0xdxn/hull20/cut-files/previews/belly-bezel.png

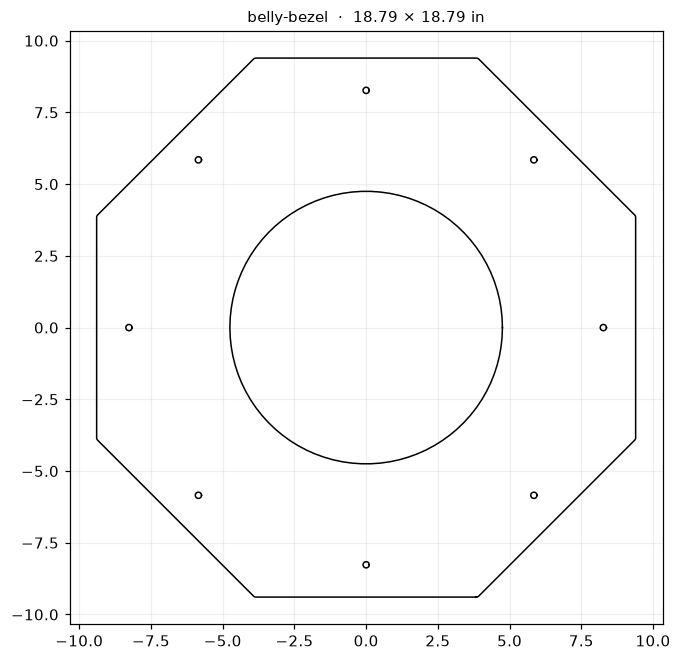
cut-files/previews/belly-bezel.png
