0xdxn/hull20/cut-files/previews/belly-panel-leg.png

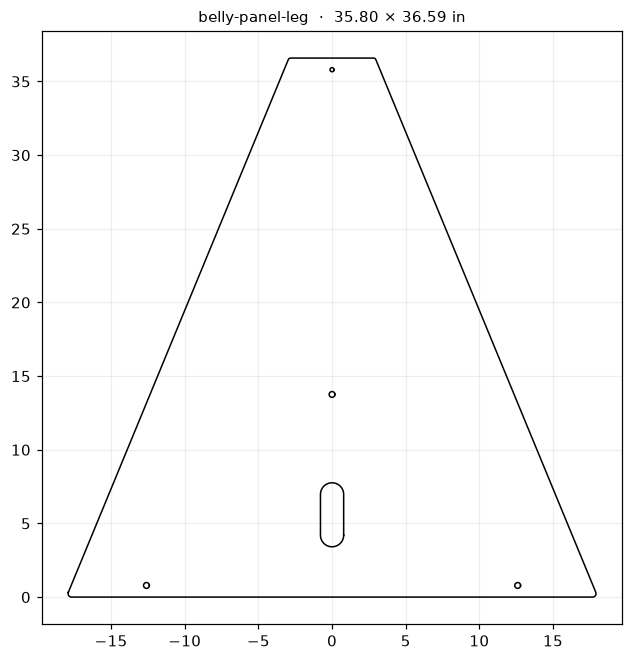
cut-files/previews/belly-panel-leg.png
