0xdxn/hull20/cut-files/previews/centre-plate.png

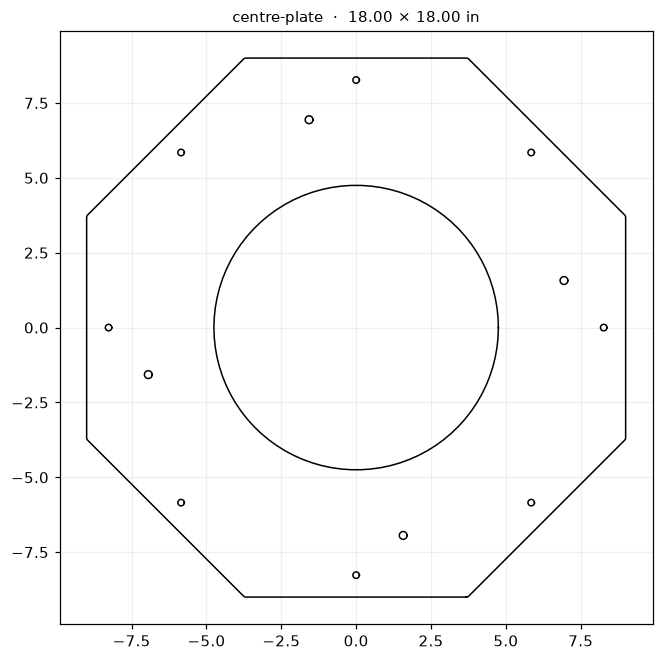
cut-files/previews/centre-plate.png
