0xdxn/hull20/cut-files/previews/deck-plate.png

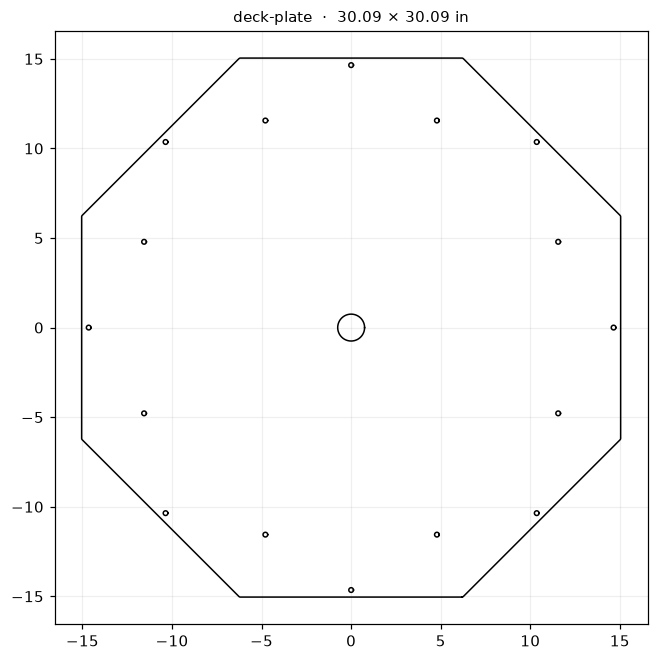
cut-files/previews/deck-plate.png
