0xdxn/hull20/cut-files/previews/porthole-plate.png

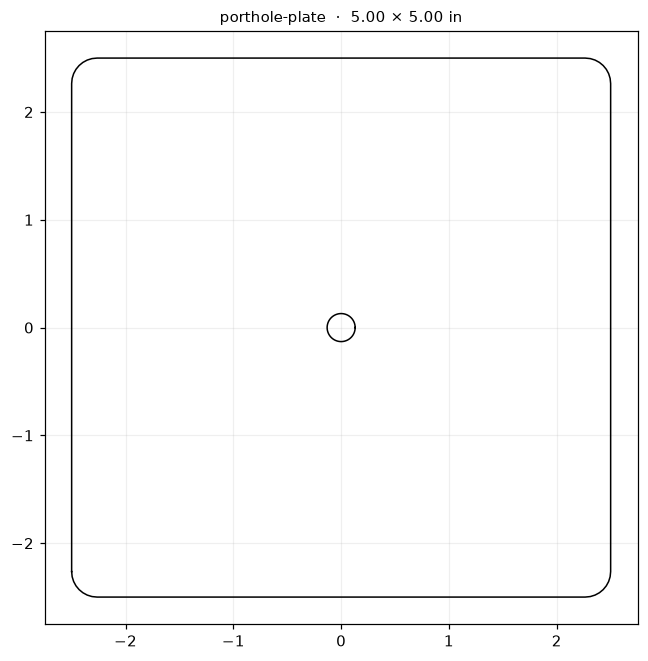
cut-files/previews/porthole-plate.png
