0xdxn/hull20/cut-files/previews/top-panel-lift.png

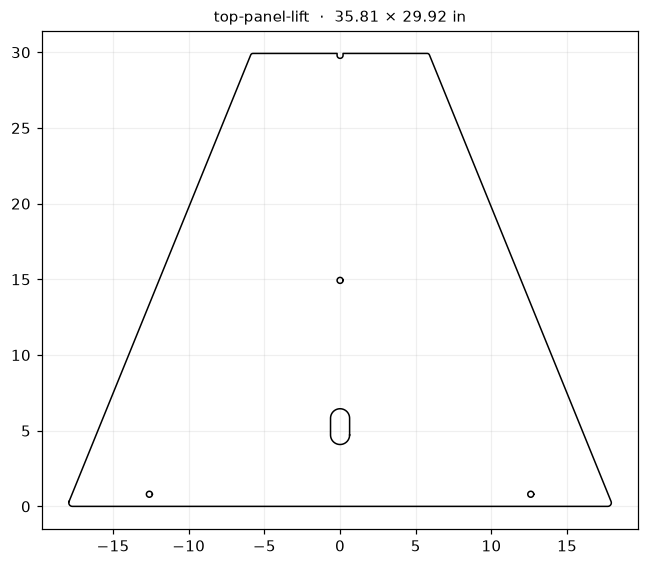
cut-files/previews/top-panel-lift.png
