0xdxn/hull20/sim/assets/plan-belly-uv.jpg

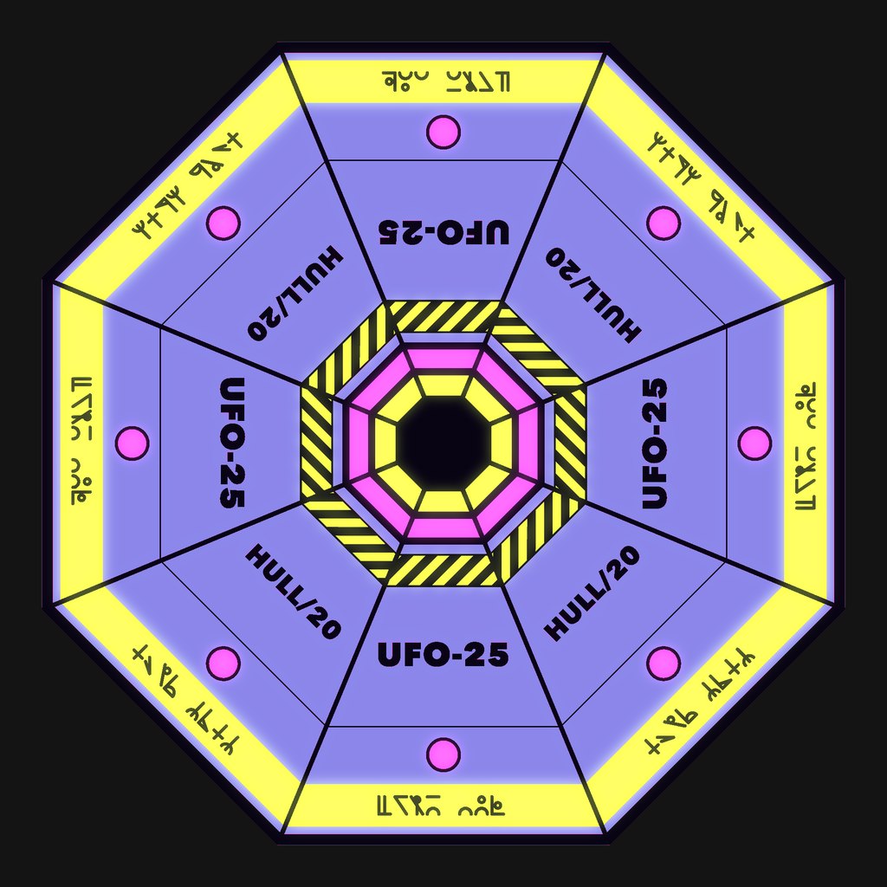
sim/assets/plan-belly-uv.jpg
