0xdxn/hull20/sim/assets/plan-belly.jpg

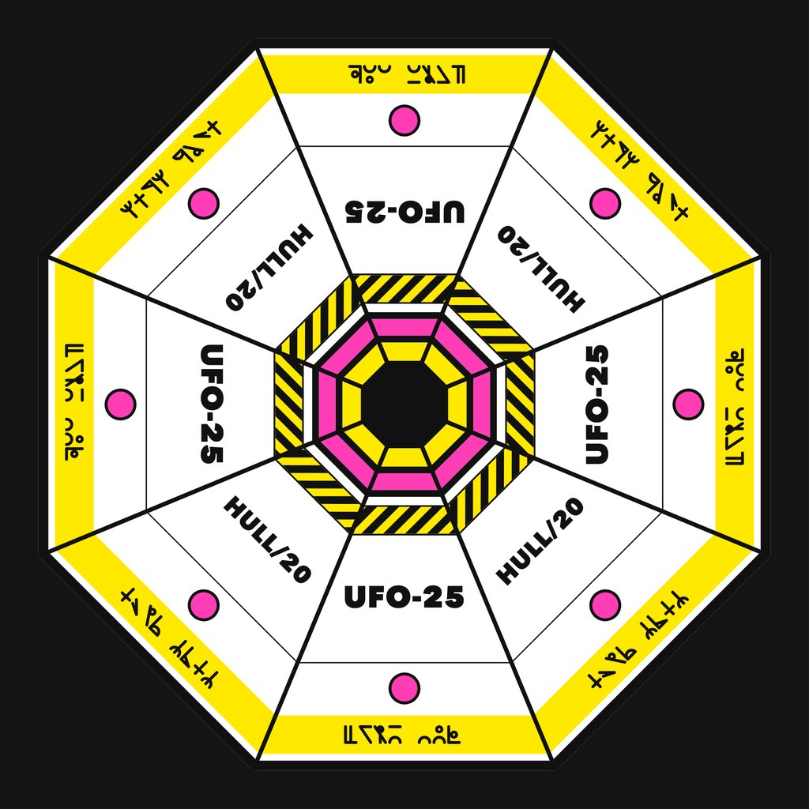
sim/assets/plan-belly.jpg
