0xdxn/hull20/sim/assets/plan-top-uv.jpg

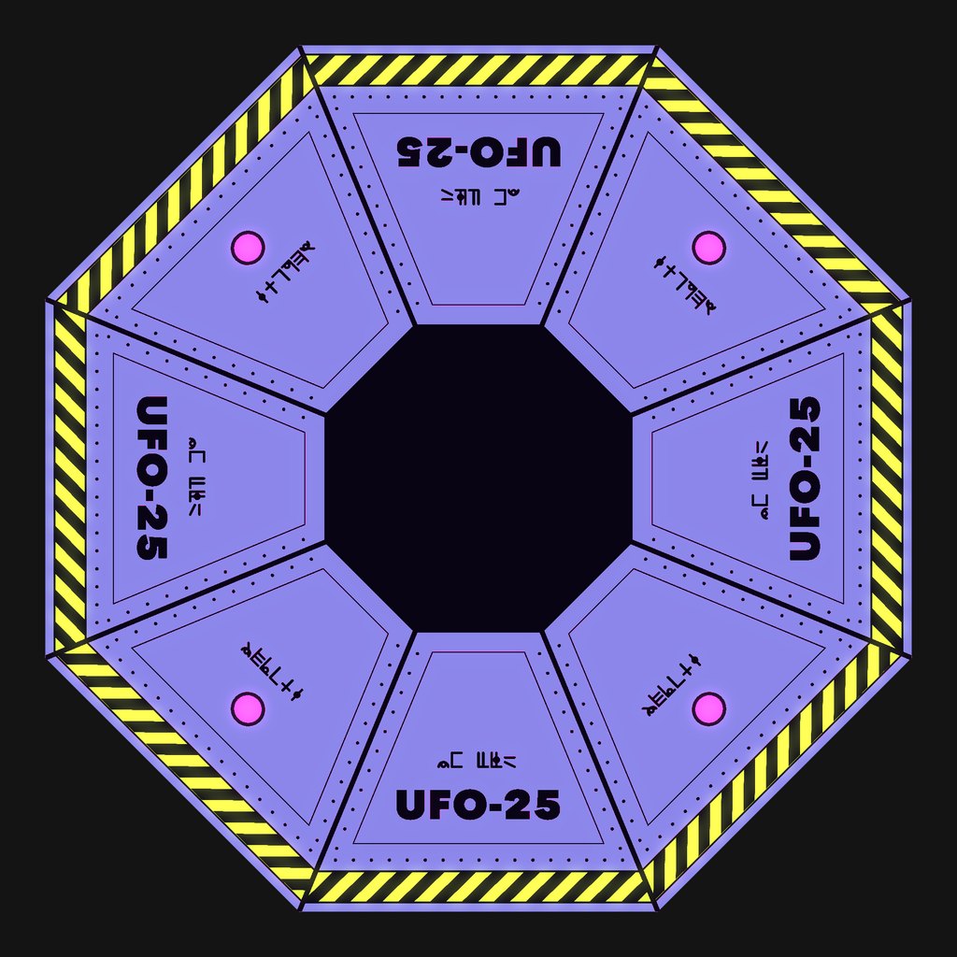
sim/assets/plan-top-uv.jpg
