0xdxn/hull20/sim/assets/plan-top.jpg

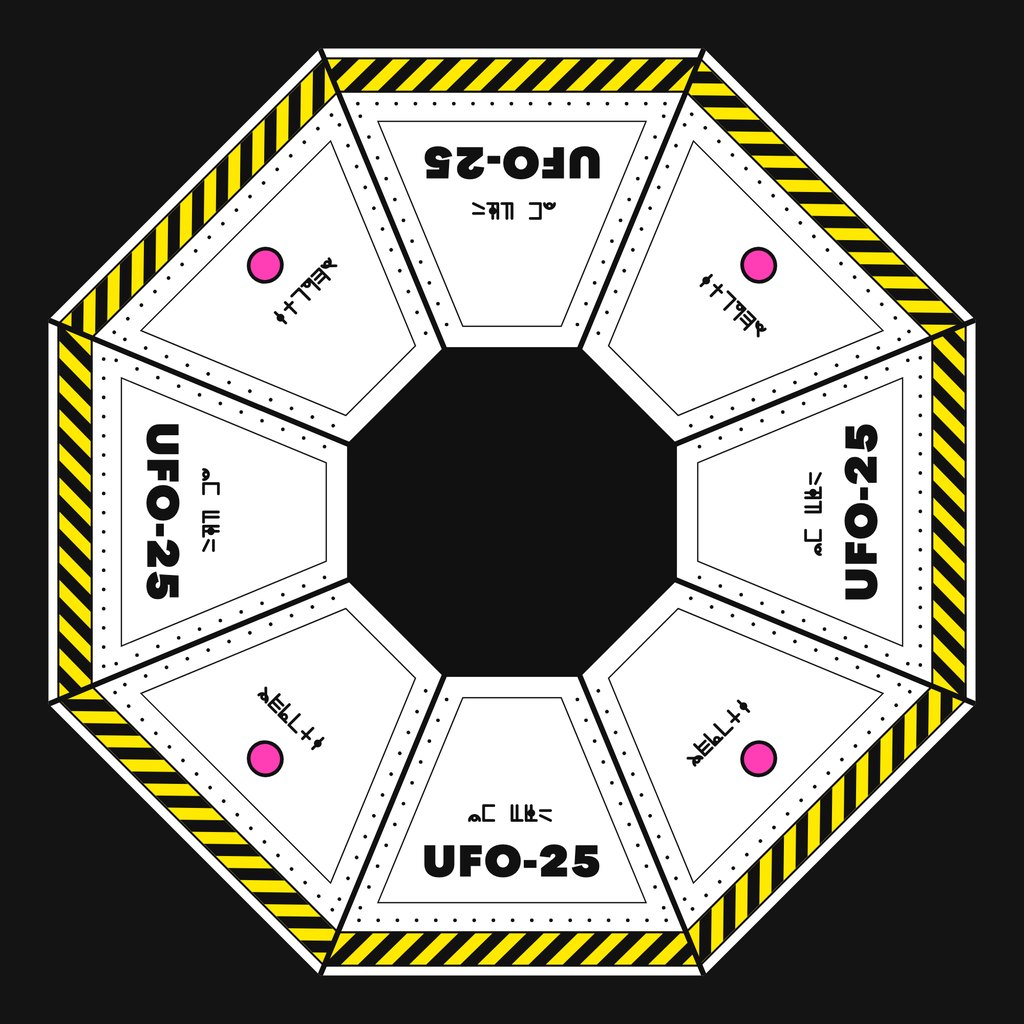
sim/assets/plan-top.jpg
