0xdxn/hull20/pcb/boarding-pass/fab/boarding-pass-bom.csv

Comment | Designator | Footprint | LCSC Part #
LTST-C230KSKT | D1,D2,D3,D4,D5,D6 | LED_LTST-C230 | C125108
USB-C | J1 | USB_C_HRO_TYPE-C-31-M-12_Flush | C165948
MMBT3904 | Q1,Q2 | SOT-23 | C20526
5.1k | R1,R2 | R_0603_1608Metric | C23186
100k | R3 | R_0603_1608Metric | C25803
10M | R4 | R_0603_1608Metric | C7250
4.7M | R5 | R_0603_1608Metric | C177475
220 | R6,R7,R8,R10 | R_0603_1608Metric | C22962
4.7k | R9 | R_0603_1608Metric | C23162
