0xdxn/hull20/cut-files/top-panel-lift.dxf

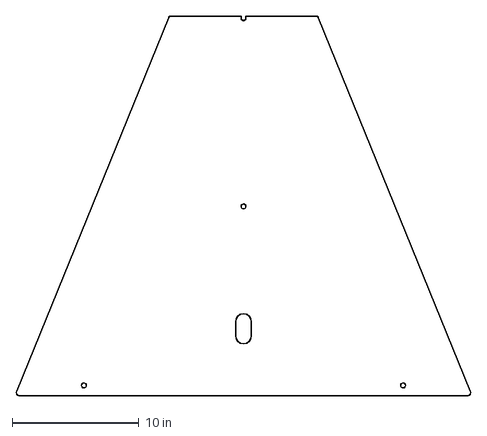
[picture p13: CAD file, 2026-11-01]
cut-files/top-panel-lift.dxf
35.9 x 29.9 in
