0xdxn/hull20/cut-files/deck-plate.dxf

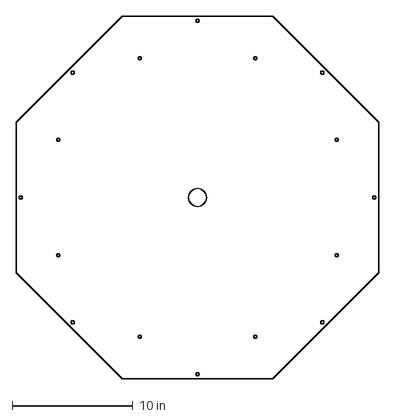
[picture p14: CAD file, 2026-11-01]
cut-files/deck-plate.dxf
30.1 x 30.1 in
