0xdxn/hull20/cut-files/belly-panel.dxf

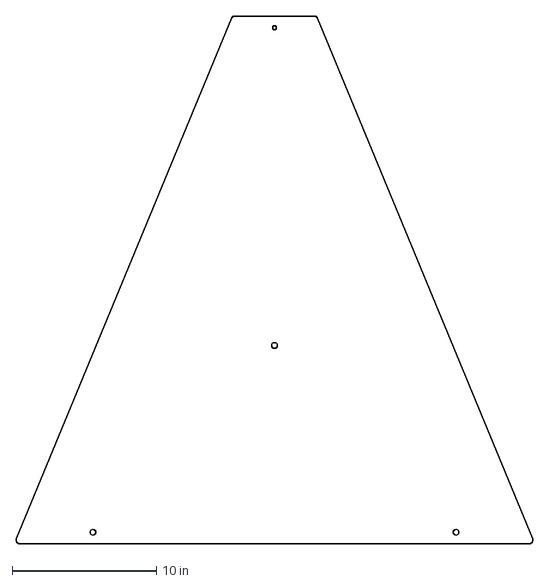
[picture p15: CAD file, 2026-11-01]
cut-files/belly-panel.dxf
35.9 x 36.6 in
