0xdxn/hull20/cut-files/belly-panel-leg.dxf

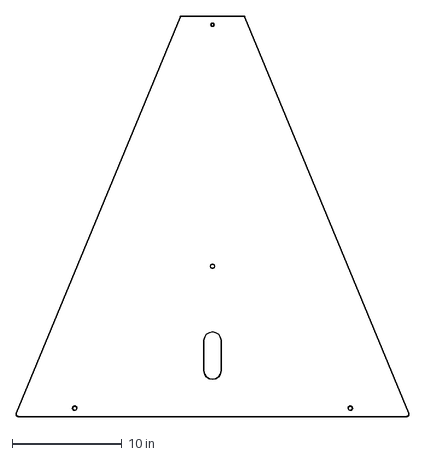
[picture p16: CAD file, 2026-11-01]
cut-files/belly-panel-leg.dxf
35.9 x 36.6 in
