0xdxn/hull20/cut-files/belly-bezel.dxf

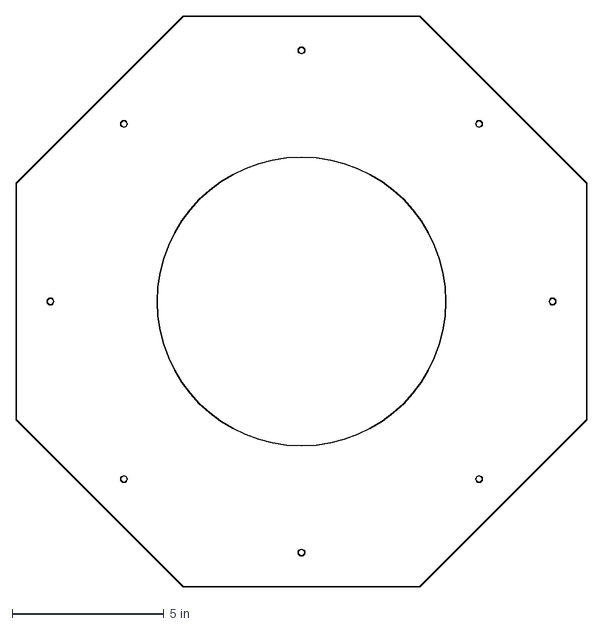
[picture p17: CAD file, 2026-11-01]
cut-files/belly-bezel.dxf
18.8 x 18.8 in
