0xdxn/hull20/cut-files/top-panel.dxf

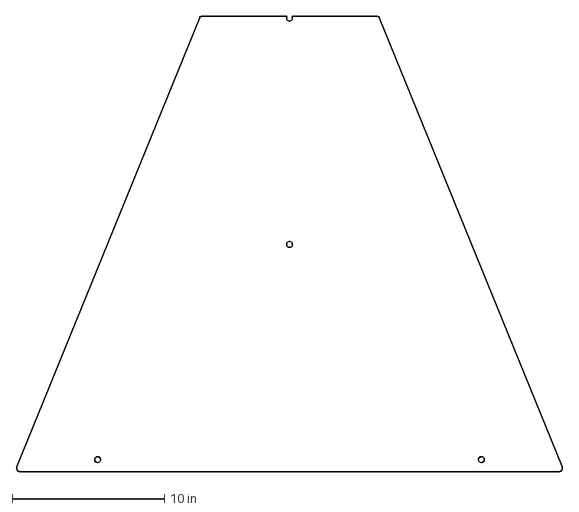
[picture p18: CAD file, 2026-11-01]
cut-files/top-panel.dxf
35.9 x 29.9 in
