0xdxn/hull20/cut-files/centre-plate.dxf

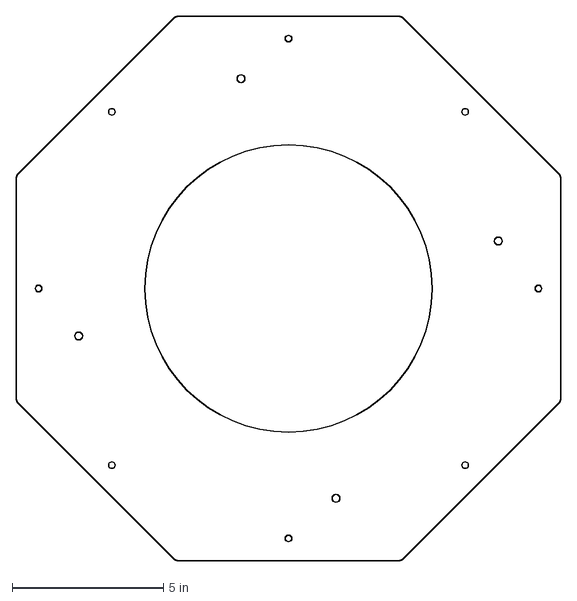
[picture p19: CAD file, 2026-11-01]
cut-files/centre-plate.dxf
18.0 x 18.0 in
