0xdxn/hull20/cut-files/porthole-plate.dxf

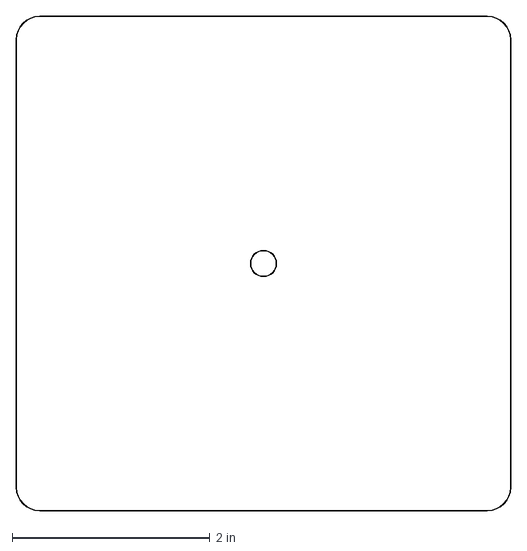
[picture p20: CAD file, 2026-11-01]
cut-files/porthole-plate.dxf
5.00 x 5.00 in
