0xdxn/hull20/frame/ASSEMBLY.html

# UFO frame: putting it together

The build in order, from the frame plan (FRAME-2020.html, build order and joints J1 to J12). Drawings are from above, B1 pointing right, numbered counter-clockwise. Holes come from DRILL-TAP.

this stepalready built

Every M6: a drop of blue Loctite 243 (not on the temporary hub-ring screws). Snug everything in a step first, check it, then tighten. Hex keys: 4 mm (M6 socket and button heads), 3 mm (M5 flat-heads).

## What the D (core ring) holes are for

Hole | Which D | Joint | What goes through it
68.9 | all 8 | J3 | M6 × 40 from inside the ring into the spoke's IN end: it's what holds each spoke to the centre
29 | all 8 (drilled on all) | J8, J11 | D2, D4, D6, D8: M6 × 40 down into a plate leg (the legs carry the centre plate, beam pod, iris). D1 and D5: one box-rail bolt each (step 7). D3 and D7: spare, leave empty
≈ 45, both ends | all 8 | J7 | the 135° corner brackets that make the eight D pieces one ring
rail holes | D1, D5 | J11 | M6 × 50 + nylock through each box rail (the box sits on the two rails): one end of each rail uses the existing 29 hole, the other is drilled at assembly

## Steps

### 1 Rim octagon J1 × 8

The eight A rims on the floor, countersunk 450 holes facing out. Each corner: inner corners touching, 135° bracket on the inner faces, 2 × M5 × 35 flat-head from outside + nylock (Corners section of DRILL-TAP).

Check: flat on the floor, and across the flats (outside to outside) the same three ways: 2213 mm (87⅛ in).

Hardware: 16 × M5 × 35 flat-head, 16 × M5 nylock, 8 brackets

Core ring, closer

### 2 Core ring J7 × 8

The eight D pieces into the small octagon the same way. All eight have the 29 mm hole now, so any piece can go anywhere: number them D1 to D8 going round as you fit them. Turn each so its 29 hole is on top and its dot end points the same way round (clockwise from above). That puts the extra holes on D1 and D5 exactly where the box rails need them (step 7).

Check: outside across the flats ≈ 373 mm (what the H rails were cut to), all four ways.

Hardware: 16 × M5 × 35 flat-head, 16 × M5 nylock, 8 brackets

### 3 Spokes J2 + J3, × 8

Each spoke runs from a rim mid-side to a core-ring mid-side, IN end at the core ring, B1 to D1, B2 to D2 and so on. All spoke holes (186, 558, 754) on top.

- Outer end (J2): M6 × 40 flat-head from outside the rim, through the countersunk 450 hole, into the spoke's tapped end. Sits flush; LED line A covers it.
- Inner end (J3): M6 × 40 socket-head from inside the core ring, through the 68.9 hole, into the spoke's IN end. The head sits between the two bracket legs.

Check: rim and spokes flush on top; the frame sits flat with no rock. Do opposite spokes first (B1 + B5, B3 + B7), then the rest.

Hardware: 8 × M6 × 40 flat-head, 8 × M6 × 40 socket-head

### 4 Hub posts J4 × 8

One E post (142) standing up on each spoke at the 186 hole. M6 × 40 up through the spoke from underneath into the post's tapped bottom end.

Check: posts vertical and the same way round.

Hardware: 8 × M6 × 40 socket-head

### 5 Hub ring J6 × 8, J5 temporary

Build the eight C pieces into an octagon (brackets as before), then set it on the posts: each C's centre 150 hole over a post.

For now: one M6 × 40 down through each 150 hole into the post's top (spares from the third pack). Later, when the deck plate goes on over the mesh, each one is swapped for the M6 × 50 that goes through the deck too (J5).

Hardware: 16 × M5 × 35 flat-head, 16 nylocks, 8 brackets; 8 × M6 × 40 (temporary)

### 6 Porthole posts J10 × 8

One K post (60) on each spoke at the 558 hole. M6 × 40 up through the spoke into the post. The porthole plates go on later (M6 × 25 down through the plate).

Hardware: 8 × M6 × 40 socket-head

Core ring, closer

### 7 Box rails J11 × 2

The two H rails (373) lie across the top of the core ring, from D5 to D1, 39.9 mm either side of the centre (79.8 mm apart), ends flush with the ring's outside faces. Not 50: at 50 every rail hole would land 10 mm from the extra 29 mm hole. At 39.9 the extra holes are rail holes.

- Each rail uses one hole that's already there: the 29 hole on D1 for one rail, the 29 hole on D5 for the other (they sit on opposite sides because the dot ends all point clockwise).
- Set the rail over the existing hole and drill 6.5 mm down through the rail, using the hole in the ring as the guide. At its other end, drill straight down through rail and ring together, 10 mm from the rail end (rail centred on the D bar). That end's hole is 29 mm from the D's other end: 2 new ring holes in all.
- Before drilling, check the bit clears the corner-bracket bolts inside the ring; slide the rail a few mm if not.
- M6 × 50 down through rail and ring, nylock underneath.

Hardware: 4 × M6 × 50 button-head, 4 × M6 nylock

Core ring, closer

### 8 Centre plate J8 × 4

Four F legs (90) hang under D2, D4, D6, D8: M6 × 40 down through each 29 mm hole into the leg's tapped top. Then the ½ in centre plate (18 in octagon, 9½ in beam port) under the legs: M6 × 25 up through the plate into each leg.

Hardware: 4 × M6 × 40 socket-head, 4 × M6 × 25 button-head + fender washers

### 9 Lift points J12 × 4

On B1, B3, B5, B7, centred 814 mm from IN (1000 mm from the centre): a 316 pad eye on top and one underneath, sharing two holes. Mark the holes from the pad eye, drill 6.5 mm, 2 × M6 × 40 straight through + nylocks. Rigging Fig 3 has the bridle.

Hardware: 8 pad eyes, 8 × M6 × 40, 8 × M6 nylock

## After the frame

From the frame plan's build order: LED channels (line A on the rim, belly battens rim to plate), snag-proofing (file and tape the 16 outside corners, cap the 48 bolt tails, scrap-of-mesh test), belly sail into the rim's inner slot, aluminet into the rim's top slot, then the deck plate over the mesh on the hub ring (swap the 8 temporary screws for M6 × 50, J5), riser posts (J9, M6 × 25 up through the deck and down through the dome lip with fender washers), dome lip. Full show on the ground, then hang.
