0xdxn/hull20/docs/wiring/CONTROLLER-STACK.html

# UFO controller · wire it one connection at a time

Two boards, stacked. Board A (the big one, rows 1–30) holds the Nano ESP32 and one chip, U1. Board B (the small one) holds four resistors, and it's where the wires to the light strips and from the power box are soldered in. There are no screw terminals: every wire is soldered straight into a hole. Six short wires join the two boards.

Updated 2026-10-25 to match what's on the ship: no fog machine and no beams. Everything that stays is in the same holes as before, so anything you've already soldered is still right.

## Parts list

How many | Part | How to find it | Goes
4 | 330 Ω resistors (R1–R4) | Colour bands orange, orange, brown, gold (4-band), or orange, orange, black, black, brown (5-band). Not sure? A meter on Ω reads about 330. Either way round. | Board B, standing up, hole h
1 | C1, 0.1 µF ceramic capacitor | Small, usually yellow or tan, two legs, printed 104. Either way round. | Board A, next to the chip
1 | C3, electrolytic capacitor, 100 µF or bigger (10 V or more) | A can. 100 µF is fine here; 1000 µF was the first plan. The stripe marks the − leg (also the shorter leg): it goes to GND, row 3. | Board B
1 | U1, 74AHCT125 chip | 14 legs, printed 74AHCT125 (or 74HCT125). Notch toward row 1. Stays out of its socket until the bench test. | Board A, in its socket
1 | 14-pin chip socket | Holds U1, so the chip itself is never soldered. | Board A, rows 17–23
2 | 15-pin female headers | The Nano ESP32 plugs into these. | Board A, rows 1–15
1 | Nano ESP32 + its USB-C power-only lead | The lead's red and black wires solder into board B. | Board A (Nano), board B (lead)
— | Wire: 20 AWG for power | The two wires from the power box's F6 fuse (red +5 V, black GND). 20 AWG or thicker. | Board B, rows 1 and 3, hole a
— | Wire: 22 AWG for data and jumpers | The four strip cables (DATA + GND each), the six ~10 cm wires between the boards, and the short jumpers on board A. Insulated, so it can cross over copper. | Both boards

### Telling the two capacitors apart

Only have up to 100 µF? Use a 100 µF can for C3 (10 V or more, stripe to row 3). This board only feeds the Nano and the chip, which draw very little, so 100 µF is plenty. Don't use the tiny ones (10 µF, 47 µF). Still not sure? Send a photo of the ones you have and I'll name each one.

No screw terminals. Every wire, including the power-box wires and the strip cables, is soldered straight into its hole.

## What the marks in the drawings mean

Each coloured line in a drawing is one separate wire with exactly two ends. Nothing is spliced together. The two ends are the two holes circled in that wire's step: solder one end in each. A wire only connects where it ends in a hole.

Naming a hole: row 17, hole A means go down to row 17 (numbers down both sides), then across to hole A (letters along the top and bottom). Board B's holes are lower-case: row 1, hole a. On board A, holes A to E of one row sit on one copper bar and are already joined; so are F to J. One row is not joined to the next, and the left half is not joined to the right half.

The basics: power versus data, and how the copper joins holes

### 1 · What runs to each light strip?

Every strip has three wires: +5 V, GND and DATA. They come from two different places:

- Power (+5 V and GND) comes from the power box, through its fuses, straight to the strips. It does not go through this little controller board. Nothing is 12 V any more (the beams are gone).
- DATA comes from this controller board. Each run of lights gets one 2-wire cable soldered into board B: DATA + GND. The GND in that cable is a reference so the data signal is read cleanly; it isn't the strip's power.

Soldered into board B | Light run | Other end: the strip's input end at
DATA row 1, hole j · GND row 3, hole j | rim edge | the aft flat's left corner
DATA row 5, hole j · GND row 7, hole j | cockpit dome lip (RGBW) | the top junction under the dome
DATA row 9, hole j · GND row 11, hole j | belly spokes, then the iris | spoke S1, at the centre
DATA row 13, hole j · GND row 15, hole j | portholes, then the alien's eyes | the top junction, to porthole P1

So: four cables leave the controller, one per run, each with a DATA wire and a GND wire. The strip's input end is the one the arrows point away from.

### 2 · How the copper on the boards works

These are prototype boards with copper bars printed underneath. On board A, the five holes A B C D E of a row sit on one bar and are joined to each other, and so are F G H I J. The two halves are not joined across the middle, and one row is not joined to the next. The long + and − bars down each side join every hole along them. Board B works the same way, just smaller.

The rule: you only add a wire when two things are on different bars. If two things already sit on the same bar, the copper has joined them; don't add a wire. Every step tells you exactly which two holes to join.

## Build it

◀ Back Next ▶ One stepWhole board

done Done, next ▶

Left and right arrow keys move between steps. The page remembers your ticks and where you were.

Everything at once, for checking at the end. It's busy on purpose; build from One step, one wire at a time.

## Bench test before it goes in the box

1. Chip out, Nano out. Meter board A: no beep between the + rail and the − rail.
2. Meter board B: no beep between row 1 and row 3 on the left half (+5 V and GND).
3. Push U1 into its socket, notch toward row 1. Push the Nano into its headers, USB-C at the row 1 end.
4. 5 V on the power-in wires (row 1, hole a and row 3, hole a) from the power box (through F6) or a bench supply. Nano powered by its USB-C lead.
5. Flash the test firmware (firmware/ufo-test: all four lines at once, each in its wire's colour: rim green, cockpit blue, spokes purple, portholes cyan). Connect a short test strip to one strip cable at a time (its DATA and GND wires, with the test strip's own 5 V from the same supply) and check it shows that line's colour. Passed 2026-10-25.
