0xdxn/hull20/docs/wiring/STRIP-PLAN.html

# UFO 2026 · strip plan

5 strips · 888 RGB + 115 RGBW used · 312 RGB + 185 RGBW spare · 10 cuts · nothing to buy · 2026-10-14

What you have and where every LED goes. The underside rim (line B) is dropped. The top rim is one continuous run, and the belly spokes are cut and joined with wire. Your four RGB strips and the RGBW strip were all bench-tested good on 2026-10-14. The wiring page (WIRING.html) carries the same data lines.

## 1 · Five strips, cut by cut

Each bar is one 5 m reel at 60 LEDs/m, input end on the left (the arrow on the strip points away from it). ✂ numbers match the checklist in section 5. Grey hatching is spare: leave it on the reel, uncut.

## 2 · Top rim: one continuous run (data line 1)

Seen from above. The strip runs clockwise from the aft flat's left corner (as on the wiring page), 55 LEDs per face, and passes uncut through each corner gap between the 36" channels. Strip 1 plugs into strip 2 with their factory connectors on face 6. Power taps at four corners, as before.

## 3 · Belly: eight spokes, snaked with wire (data line 3)

X-ray from above, same orientation as the top view. The data snakes through the spokes: S1 runs centre → edge, a wire runs along the edge to S2, S2 comes back in, a short wire crosses the hub to S3, and so on. S8 ends at the centre and feeds the iris. The firmware already maps this zig-zag.

## 4 · Four data lines

Line | Pin | Runs | LEDs | Strip
1 | Nano D2 · GPIO5 | top rim, clockwise from the aft-left corner | 440 | RGB 1 (300) → RGB 2 (140)
2 | Nano D3 · GPIO6 | cockpit: the 24" dome lip, from the top junction | 115 RGBW | RGBW, 4 bytes per LED, so it gets a line of its own
3 | Nano D4 · GPIO7 | spokes S1 → S8 snaked, then the iris disc | 448 + 241 = 689 | RGB 3 (S1–S5) RGB 4 (S6–S8) · iris: a 241 disc borrowed back from the round eyes
4 | Nano D5 · GPIO8 | top junction → portholes P1…P8 → the alien's 2 eye pixels | 128 + 2 = 130 | 8 of your 10 porthole rings (2 spare)

The longest line (3, 689 LEDs) still sets the frame time, about 48 frames a second. Line 2 carries far fewer LEDs than line B did. At its warmest, though, an RGBW pixel can draw a little more than an RGB one; the 30 A limiter covers it.

## 5 · Cuts and seals

1. Mark before you cut. Count LEDs from the input end and cut on the copper pads between two LEDs, through the middle of the pads.
2. The 10 cuts: ✂1 RGB 2 at 140 (end of the rim) · ✂2–✂6 RGB 3 at 56, 112, 168, 224, 280 (S1–S5) · ✂7–✂9 RGB 4 at 56, 112, 168 (S6–S8) · ✂10 RGBW at 115 (cockpit; measure the lip first, see below).
3. 20 cut ends get sealed. Where a jumper goes on, solder first, then seal: silicone end cap filled with neutral-cure silicone, or glue-lined heat shrink over the sleeve. The spare pieces' cut ends get sealed too, so the spares stay IP67.
4. Jumpers (22 AWG 3-core, #16): 4 at the rim (S1→S2, S3→S4, S5→S6, S7→S8), about 33" each; 3 at the hub (S2→S3, S4→S5, S6→S7), about 5" each; S8 → iris about 7". Leave 2" slack at each end.
5. Your heat-shrink-sealed strip is best as RGB 4. Its three spokes sit in belly channels, under the saucer and out of the rain, and most of it stays on the reel as the spare.
6. Measure the dome lip before ✂10. 115 LEDs assumes 75.4" (π × 24") at 60/m. Wrap a tape where the strip will actually sit; LEDs = inches × 0.79 (60/m). If the strip turns out to be 30/m, it's half that and the cut moves.

Spares: RGB 2 keeps 160, RGB 4 keeps 132, RGB 3 keeps 20 (312 RGB) and the RGBW keeps 185. A failed spoke or rim face can be swapped on show night. Also spare: the dense 1 m strip in its channel (wand or antenna) and a loose dense 1 m strip. Count its LEDs: 144/m is the usual dense density.
