0xdxn/hull20/docs/wiring/WIRING.html

# UFO 2026 · wiring

Current as of 2026-10-14. Four data lines: 1 top rim, 2 cockpit dome lip (RGBW), 3 belly spokes then iris, 4 portholes then eyes. Which strip becomes which run, every cut and the spoke jumpers: STRIP-PLAN.html. Anything drawn in purple dashes was planned and not built (a 12 V beam pod and a fog relay).

5 V: 1,374 px on 4 data lines (1,259 RGB + 115 RGBW) · cap 42 % · limiter 30 A · beam pod and fog relay: planned, not built
Controller Arduino Nano ESP32 (ESP32-S3; 5 V in through its USB-C port) + 2 × 74AHCT125 · Mean Well LRS-350-5 (+ LRS-75-12 only with the pod) · 6 fuses (+ F7 with the pod)
Box inside the 2020 aluminium frame, on two rails over the core ring, under the deck. Frame: ../../frame/FRAME-2020.html

+5 VGND +12 Vdata / signal mains Lmains N earthplanned, not built (beam pod, fog relay)

Mains. The only 120 V wiring is the cord into the box and the three short runs to the two power supplies. Unplug before opening the box. Plug only into a GFCI outlet. If you'd rather not do the mains side, an electrician can do those connections in a few minutes; everything else is 5 V (and 12 V for the beam pod, if fitted).

## 1 · System overview

Fig 1. One cord feeds the box. 5 V runs every pixel and the controller through six fuses, and the controller sends four buffered data lines. Purple dashes: a 12 V beam pod (LRS-75-12, F7, MOSFET) and a fog relay that were planned and not built. Leave them out and nothing else changes.

## 2 · Controller board (perfboard inside the box)

Fig 2. The four data lines go through U1 (3.3 V in, 5 V out) and a 330 Ω series resistor each. If the beam pod is fitted, D6 drives the MOSFET module directly, with a 10 kΩ pull-down so the pod stays off while the ESP32 boots. The relay gets a 5 V signal from U2 and the same pull-down, so the fog machine can't fire at power-up. Pin numbers are the 74AHCT125 DIP-14 pins.

Built on two ELPZON boards as a stack: CONTROLLER-STACK.html (hole-by-hole layout). Board build. Nano ESP32 on female headers (so it lifts out to flash), U1 and U2 in DIP-14 sockets, two-way or three-way screw terminals for J1–J6 and the 5 V input. Keep R1–R4 right at U1's outputs. Every data run leaves the board with its own GND wire beside it.

Power and flashing: the Nano ESP32 has no 5 V input pin, and its VIN needs 6–21 V (datasheet 11.3), so it takes its 5 V through its own USB-C port: a short USB-C power lead (power only) from the 5 V bus via F6. Never put 5 V on VIN. To flash, unplug that lead and plug in the laptop cable instead; nothing can backfeed.

## 3 · Power box: wiring and layout (to scale)

Fig 3a. Inside the box. Both supplies' −V go to one GND bus (one tie for the 12 V side, if the pod is fitted) so the controller, the MOSFET and every strip share a reference. The earth (⏚) of both supplies goes to the cord's ground.

Fig 3b. Box layout at 50 px per inch (inside 11.2 × 7.7 in). LRS-350-5 lies flat; LRS-75-12 sits on 1 in standoffs above its left end. The bottom strip holds the fuse row and the controller board. Mains stays in the top-right corner, away from the 5 V side. All glands are on the face that points down once the box sits on its rails inside the saucer, so water can't sit on them.

## 4 · Saucer routing (both views drawn from above; the belly is an x-ray)

Fig 4a. Top. Line 1 (lineA) runs on the 1.5 in rim edge, clockwise from the aft flat's left corner (aft at the top), one continuous strip, 55 LEDs per face. Feeds from ring bus A at the start of faces 1, 3, 5 and 7. The top junction (TJ) under the dome riser gets F2 + J2 and F5 + J4 up through the deck. Line 2 starts at the TJ and runs once round the dome lip (115 RGBW). Line 4 chains P1 → P8 on the 22/3 cable, then the eyes. The TJ also puts power into P1 and P5.

Fig 4b. Belly. Line 3 only: no strip on the belly's outer edge. The spokes are one serpentine data line: S1 runs outward, S2 inward, and so on, with rim jumpers along faces 1, 3, 5, 7 and short centre jumpers. S8 ends at the centre and feeds the iris. Spoke power comes from a star at the centre (F3); the iris has its own feed (F4).

The sim counts pixels from the middle of the aft flat. The strip starts at the aft flat's left corner, so the firmware shifts lineA by half a face (27 px). Spoke order and the serpentine direction are also mapped in firmware; wire it as drawn and the show matches the sim.

## 5 · Channels, fuses and wire

### Data channels

Ch | Nano pin | U1 in → out | Series R | Runs to | Pixels | Frame | Worst current at 42 %
1 | D2 · GPIO5 | 2 → 3 | R1 330 Ω | lineA, rim edge, from the aft flat's left corner, clockwise | 440 | 13.2 ms | 11.1 A
2 | D3 · GPIO6 | 5 → 6 | R2 330 Ω | cockpit: TJ → once round the 24" dome lip, RGBW strip (4 bytes per LED, so its own line) | 115 RGBW | 4.6 ms | ~4 A
3 | D4 · GPIO7 | 9 → 8 | R3 330 Ω | spokes S1–S8 serpentine, then the iris (centre) | 448 + 241 = 689 | 20.7 ms | 11.3 + 6.1 A
4 | D5 · GPIO8 | 12 → 11 | R4 330 Ω | top junction → P1…P8 → eyes | 128 + 2 = 130 | 3.9 ms | 3.3 A
beam | D6 · GPIO9 | direct | R5 10 kΩ pull-down | MOSFET module PWM+ (12 V pod, if fitted) | — | — | pod ≤ 5 A at 12 V
fog | D7 · GPIO10 | U2 2 → 3 | R6 10 kΩ pull-down | relay IN; COM + NO across the fog remote's button | — | — | —

The ESP32-S3 has four RMT transmit channels, one per data line, all sending at once. The longest line (ch 3, 689 px) sets the frame time, about 48 fps. "Worst current" is every pixel of that line full white at the 42 % cap (60 mA per pixel). The firmware's 30 A limiter holds the total; a single line can still reach its figure on its own, so each fuse is sized above it. With 16 portholes instead of 8, ch 4 becomes 358 px (10.7 ms) and F5 stays 10 A.

### Fuses (ATC blade, in the inline holders)

Fuse | Feeds | Rating | Wire from the box
F1 | lineA via ring bus A | 15 A | 14 AWG pair to the aft-left corner, then the ring bus
F2 | cockpit lip (RGBW), powered at the top junction | 10 A (15 A is fine) | 14 AWG pair up through the deck beside F5 (G3)
F3 | spoke star at the centre (8 spokes) | 15 A | 14 AWG pair, short: the spoke star is in the box, right over the beam port
F4 | iris | 10 A | 14 AWG pair to the disc's 5 V/GND pads, both outer ring and centre
F5 | top junction: portholes, cockpit, eyes | 10 A | 14 AWG pair up through a gland in the deck to the TJ (the box is right under it)
F6 | controller board | 3 A (5 A if the kit has nothing smaller) | 18 AWG inside the box
F7 | beam pod (12 V), only if fitted | 7.5 A | 16 AWG pair to the pod

### Wire

Run | Wire | Approx. length
Fused feeds from the box (F1–F5) | 14 AWG red/black pair | 5 × 1.5 m
Ring bus A around the inside of the rim | 14 AWG red/black pair | 7.5 m
Injection taps, bus → strip (4 per rim line), spoke star leads, TJ → P1/P5 | 18 AWG pair | ≈ 8 m
Data runs (with GND): J1 to the aft-left corner; J2 and J4 up to the TJ; J3 to S1 | 22 AWG 3-core (DATA, GND, spare) | ≈ 6 m
Spoke jumpers: 4 along the rim (36 in), 3 at the centre | 22 AWG 3-core (5 V, GND, DATA) | ≈ 4.5 m
Porthole chain P1 → P8 → eyes | 22 AWG 3-core | ≈ 6 m
Fog trigger pair (not built) | 22 AWG (2 cores of the 3-core) | —
Beam pod (if fitted) | 16 AWG pair (the pod's own lead if long enough) | ≈ 1 m

So: about 20 m (65 ft) of 14 AWG pair with slack, 8 m of 18 AWG pair and ≈ 20 m (65 ft) of 22/3. That's more than the 50 ft of 22/3 on the parts list, so get 100 ft. Put a 1000 µF capacitor across 5 V/GND where each strip starts (lineA, cockpit lip, S1, iris, TJ) plus C3 on the board: 6 in all. Seal every outdoor joint with adhesive-lined heat shrink.

## 6 · Connection checklist (tick as you go)

## 7 · Bring-up order

1. Bench, USB only. Controller board on USB, no supplies. Flash the test firmware. One short test strip on J1, then J2, J3, J4: each shows a single-pixel chase.
2. Supplies, no loads. Wire the mains side, close the lid, plug into the GFCI. Meter: LRS-350-5 at 5.0 V, trim to 5.1 V. LRS-75-12 at 12 V (if fitted). Unplug.
3. One fuse at a time, test firmware capped at 10 %: F6 (board), then F1 (lineA), F2, F3, F4, F5. On each, check the pixel count, the direction and the start corner against fig 4.
4. Voltage at the far end. Each line full white at the 42 % cap: at least 4.6 V at the last pixel. If it's lower, add a tap from the ring bus there.
5. Beam (if fitted). PWM ramp 0 → 100 %: the pod fades smoothly. Pull F6 and check that the pod stays dark (the pull-down works).
6. Full show on the ground first: clamp meter on the LRS-350-5 output during an abduction, ≤ 30 A.
7. Last. Glands tight, GFCI test button pressed, box level.

## 8 · Open items

1. Fog relay. Planned and not built.

2. Portholes 8 vs 16. Drawn for 8. 16 adds a second ring per top facet; ch 4 goes to 358 px, the chain doubles, nothing else changes.

3. Dome lip. Measure where the cockpit strip will actually sit before cutting the RGBW (✂10 on the strip plan): LEDs = inches × 0.79 at 60/m. 115 assumes 75.4".

4. Beam pod. Not built. Without it, leave out the LRS-75-12, F7, the MOSFET and gland G6; D6 stays unused.
