0xdxn/hull20/pcb/boarding-pass/fab/boarding-pass-schematic.pdf

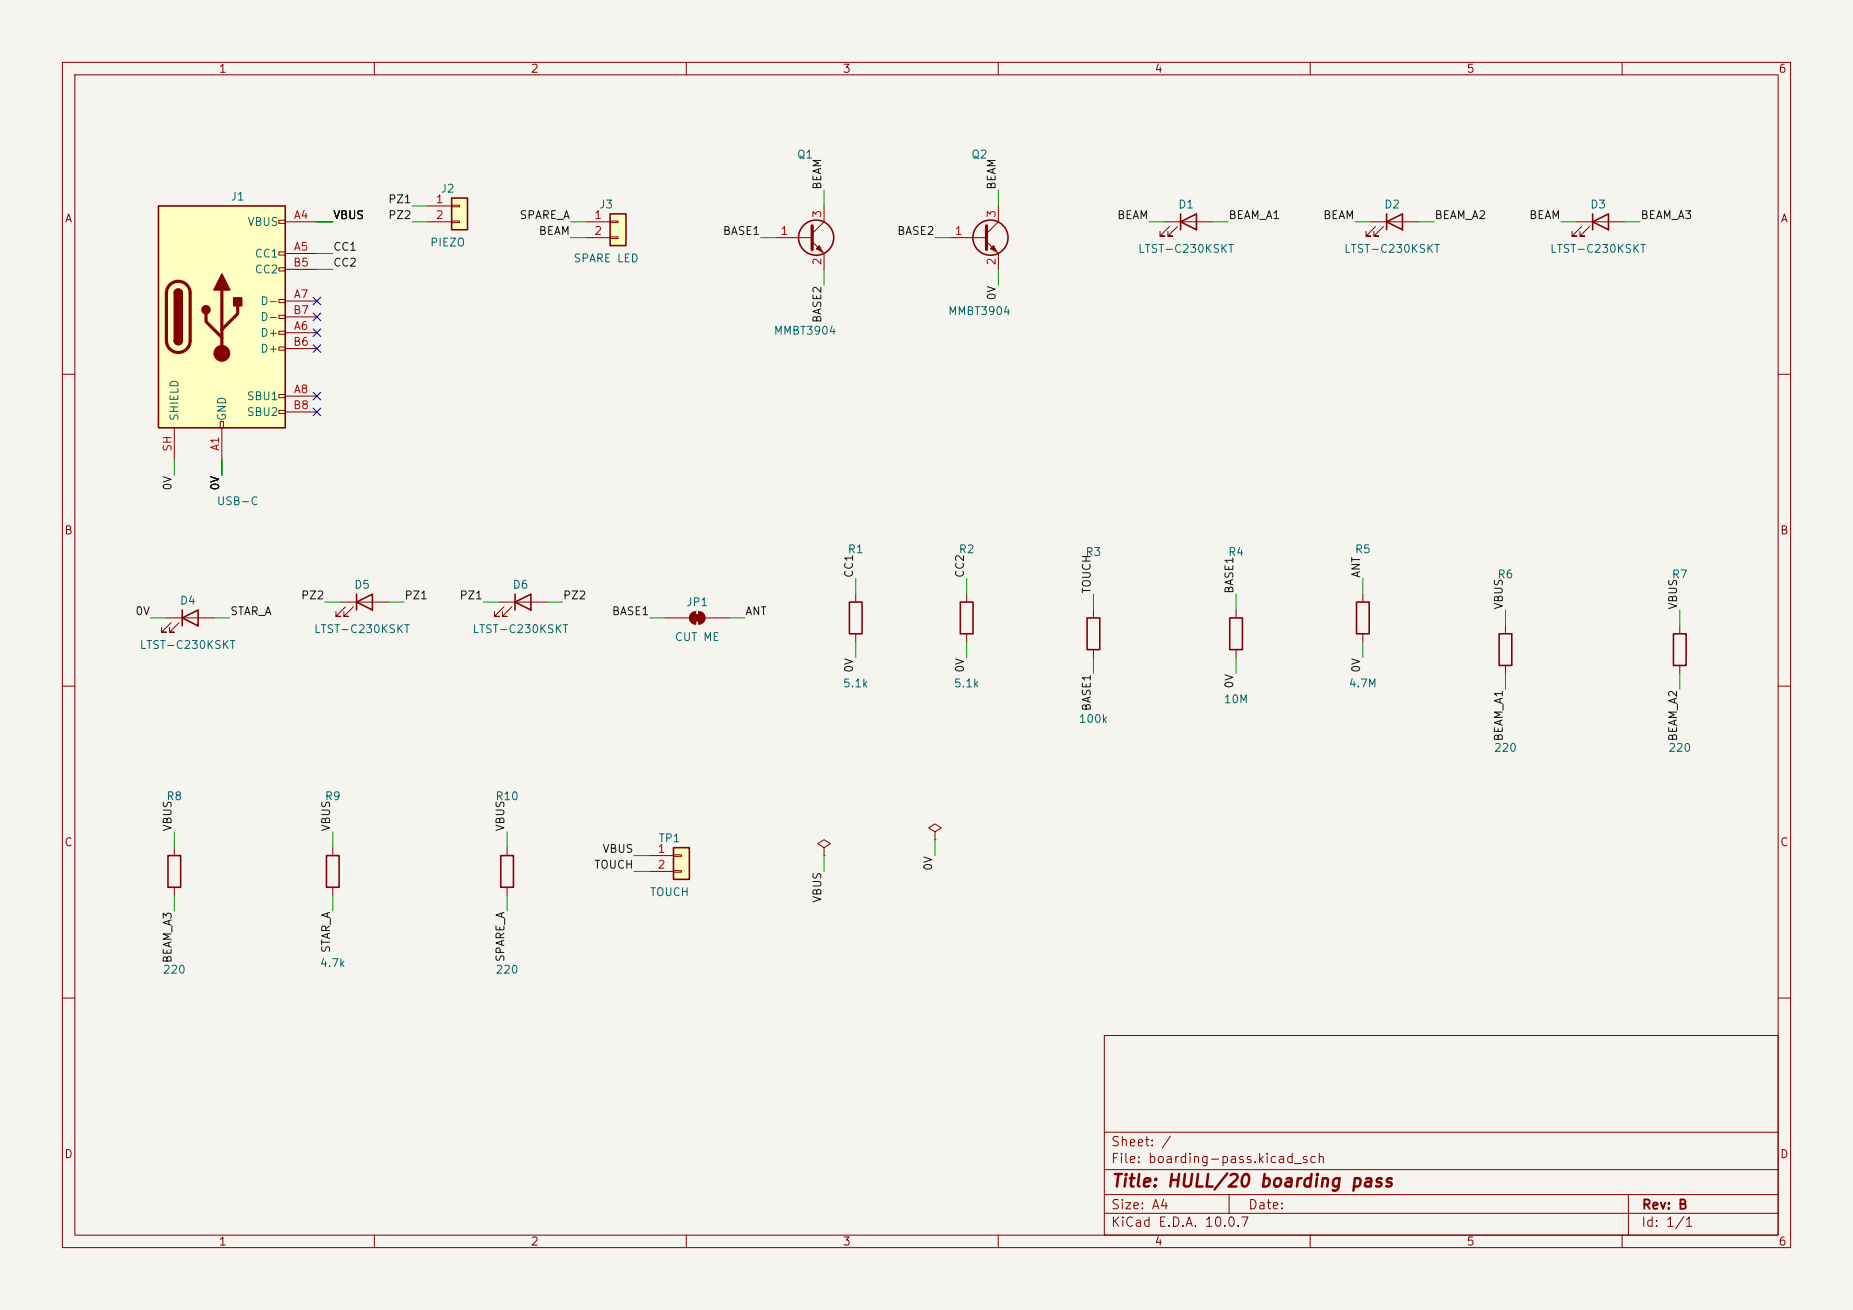
[picture p21: page 1]

Sheet: /
File: boarding-pass.kicad_sch
Title: HULL/20 boarding pass

Size: A4 | Rev: B
KiCad E.D.A. 10.0.7 | Id: 1/1
