0xdxn/hull20/pcb/boarding-pass/boarding-pass.kicad_pcb

## KiCad design pcb/boarding-pass/boarding-pass.kicad_pcb (2026-11-01)

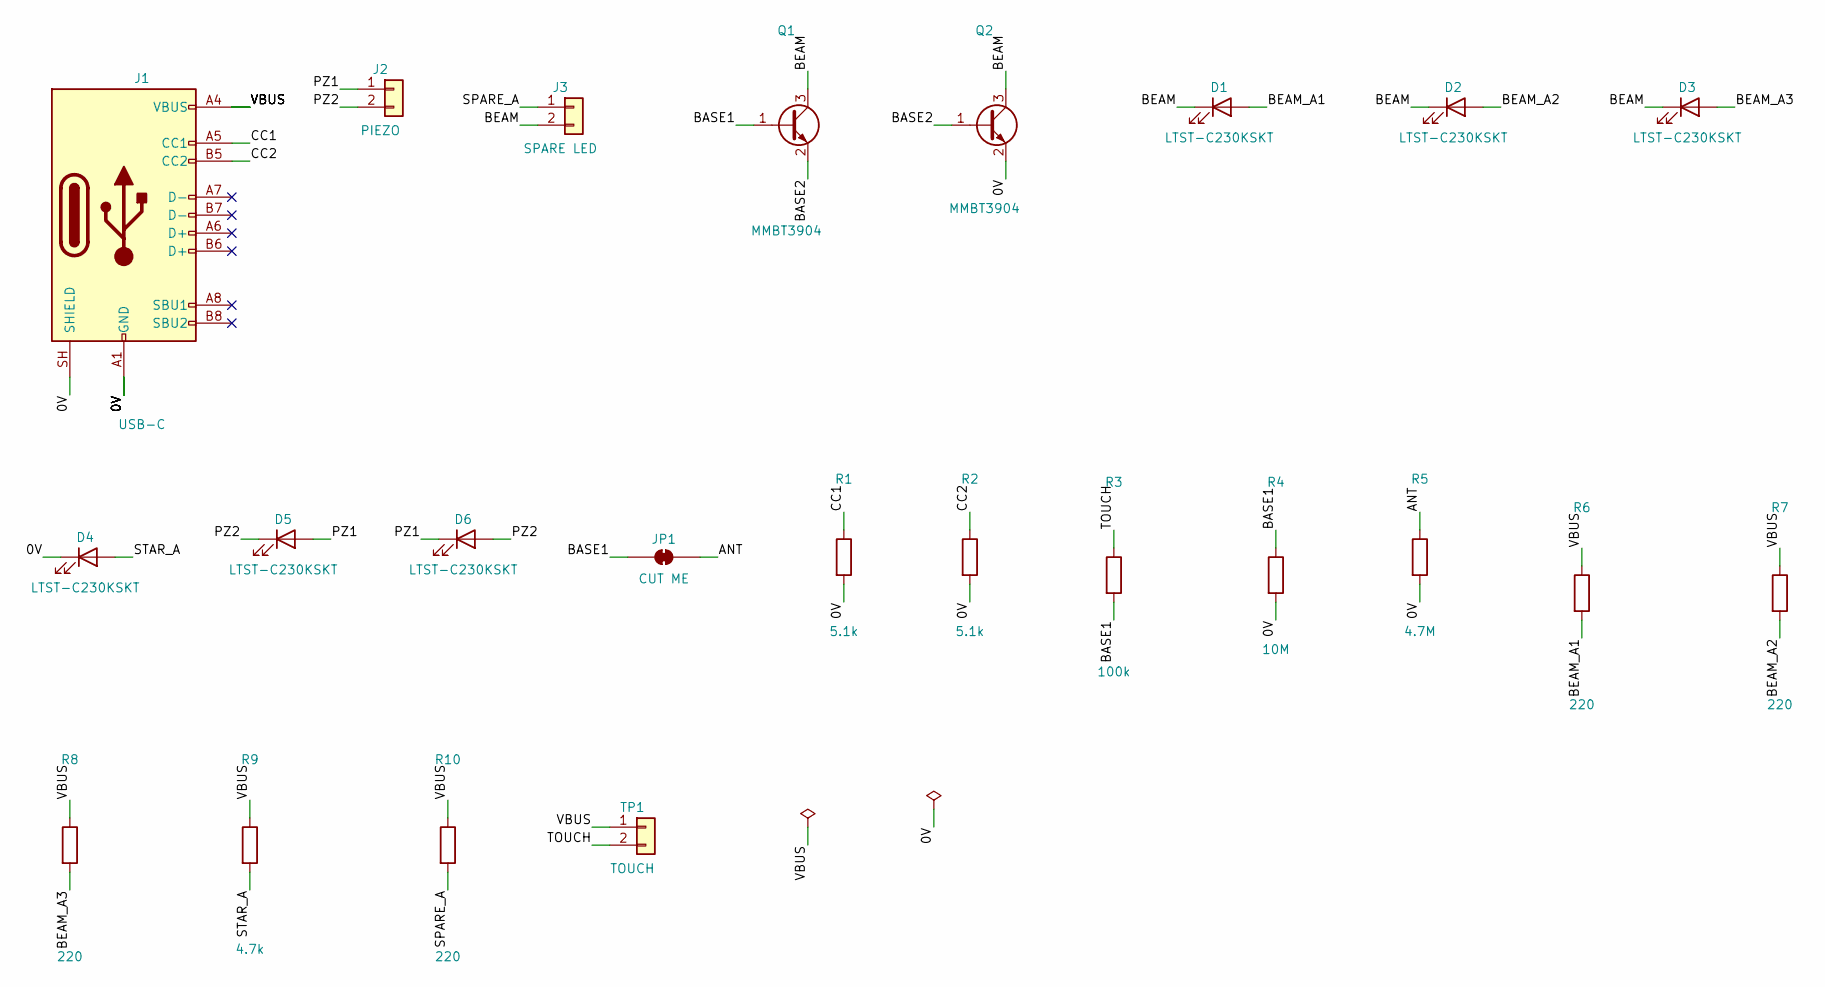
[picture p22: schematic boarding-pass.kicad_sch, HULL/20 boarding pass]

Parts:
D1, D2, D3, D4, D5, D6: LTST-C230KSKT; LED_LTST-C230; LCSC C125108
J1: USB-C; USB_C_HRO_TYPE-C-31-M-12_Flush; LCSC C165948
J2: PIEZO; PadPair_3mm
J3: SPARE LED; PadPair_3mm
JP1: CUT ME; SolderJumper-2_P1.3mm_Bridged_RoundedPad1.0x1.5mm
Q1, Q2: MMBT3904; SOT-23; LCSC C20526
R1, R2: 5.1k; R_0603_1608Metric; LCSC C23186
R3: 100k; R_0603_1608Metric; LCSC C25803
R4: 10M; R_0603_1608Metric; LCSC C7250
R5: 4.7M; R_0603_1608Metric; LCSC C177475
R6, R7, R8, R10: 220; R_0603_1608Metric; LCSC C22962
R9: 4.7k; R_0603_1608Metric; LCSC C23162
TP1: TOUCH; TouchSplit

Connections:
0V: D4.1 (K), J1.A1 (GND), J1.A12 (GND), J1.B1 (GND), J1.B12 (GND), J1.SH (SHIELD), Q2.2 (E), R1.2, R2.2, R4.2, R5.2
ANT: JP1.2 (B), R5.1
BASE1: JP1.1 (A), Q1.1 (B), R3.2, R4.1
BASE2: Q1.2 (E), Q2.1 (B)
BEAM: D1.1 (K), D2.1 (K), D3.1 (K), J3.2, Q1.3 (C), Q2.3 (C)
BEAM_A1: D1.2 (A), R6.2
BEAM_A2: D2.2 (A), R7.2
BEAM_A3: D3.2 (A), R8.2
CC1: J1.A5 (CC1), R1.1
CC2: J1.B5 (CC2), R2.1
PZ1: D5.2 (A), D6.1 (K), J2.1
PZ2: D5.1 (K), D6.2 (A), J2.2
SPARE_A: J3.1, R10.2
STAR_A: D4.2 (A), R9.2
TOUCH: R3.1, TP1.2
VBUS: J1.A4 (VBUS), J1.A9 (VBUS), J1.B4 (VBUS), J1.B9 (VBUS), R6.1, R7.1, R8.1, R9.1, R10.1, TP1.1

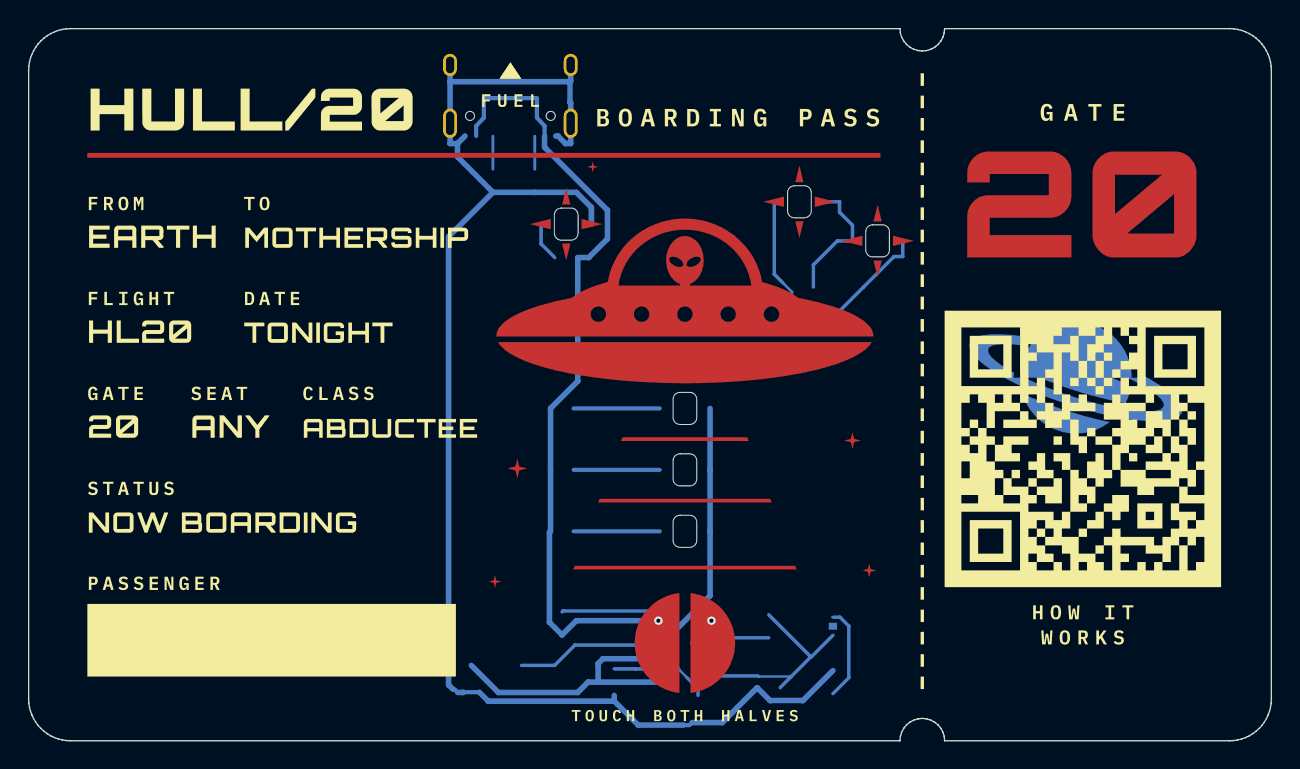
[picture p23: board boarding-pass.kicad_pcb from above]

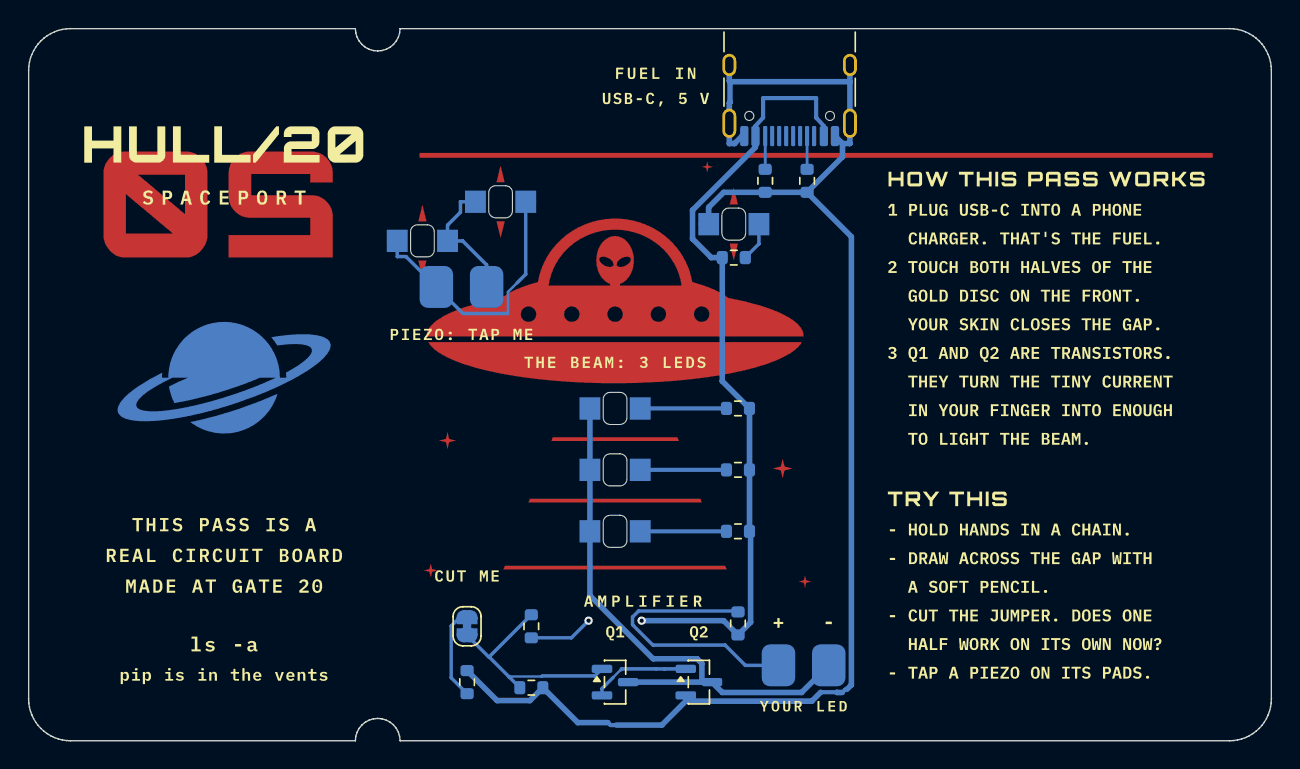
[picture p24: board boarding-pass.kicad_pcb from below]

Board: 2 copper layers, 89.0 x 51.0 mm, 23 parts (22 on the bottom side), 16 nets.
